derekmaeshiro/lebron/images/LEBRON_SOFTWARE_ARCHITECTURE.png

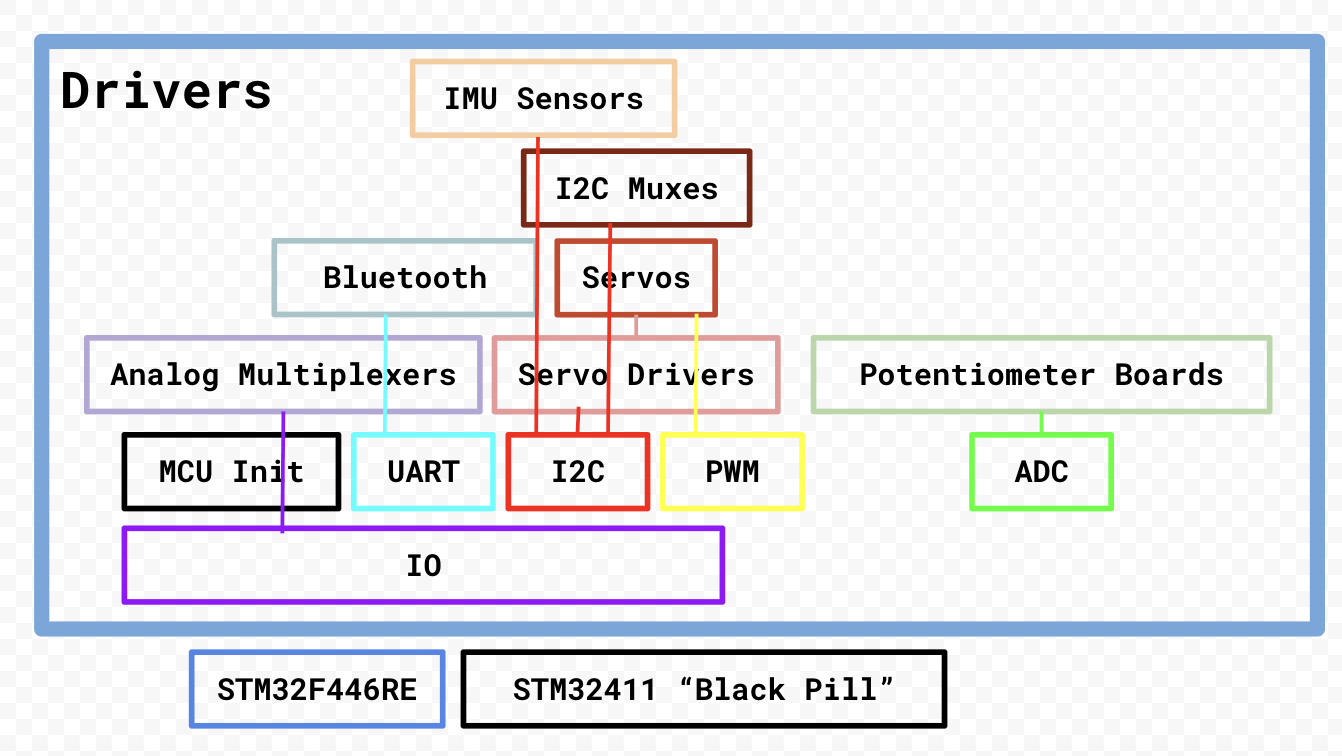
images/LEBRON_SOFTWARE_ARCHITECTURE.png
