derekmaeshiro/lebron/(commit log)

2025-07-11 build(makefile): specify the tools path for open-ocd and arm toolchain
    Make Makefile less hard-coded to a particular host by letting the path
    be specified by an environment variable.
    TOOLS_OPEN_OCD_DIR_PATH = /opt/homebrew/Cellar/open-ocd/0.12.0_1/share/openocd/scripts
    TOOLS_ARM_DIR_PATH = /Applications/ArmGNUToolchain/14.3.rel1/arm-none-eabi
2025-07-11 update tools path for arm-none-eabi-gcc in workflows
2025-07-12 removed include path and kept arm-gcc-include path for Makefile
2025-07-13 edit Makefile to include correct paths for led.c
    [defines.h, io.c, io.h, main.c]
2025-07-17 feat(drivers): implement IO handling
    The pinmapping for the nucleo works through LED test functions.
    I haven't set up the pinmapping for the Black Pill yet, but will do
    so at a later stage. Created enums to represent the pins (PA0 to PD2).
    IO Implementation uses resistor, output, input, MODER, and AFR registers
    to configure pins.
2025-07-18 1. add pin configurations using stm32 datasheet 2. configure each pin to either a) intentional pin that I will use or b) unused pin that may be used later on, which is set to analog 3. io_implementat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
2025-07-18 feat(build): pass hardware target as argument to make
    I hard code define to select between hardware targets (STM32F446RE and
    STM32F411) since each has different pinouts for programming. This
    handling is done in the Makefile using defines at compile time.
    Build for robotic arm: make HW=ROBOTIC_ARM
    Build for arm sleeve: make HW=ARM_SLEEVE
2025-07-19 add files that didn't get added the first time
    [io.c, main.c]
2025-07-21 feat(assert): add assert feature - doesn't use the BREAKPOINT feature by default since in STM32, under debugger mode, it stops the blinking completely. The blinking is important in visually recognizi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
    [assert_handler.c, assert_handler.h, defines.h, io.c, io.h, led.c, led.h, main.c]
2025-07-22 completed adc.h and temporarily set up IO_ANALOG_MUX_COM_1 pin for adc. also began basic configuration in adc_init for the ADC related registers
2025-07-22 feat(interrupts): add interrupts to io.c and test functions in test.c
    STM32 uses a similar process to other mcu's in the interrupt process.
    Instead of using ports to specify pins, it uses the pins directly. This
    means that there are only 16 possible pins that can be configured as an
    interrupt with 7 handlers in total. The process of configuring an
    interrupt starts by enabling the clock. Then, a pin is sslected and
    saved in teh SYSCFG register. Afterwards, the interrupt is disabled and
    a trigger is saved. Then, the interrupt is enabled.
    Interrupts must be globally enabled and are done so in the mcu_init
    function.
    The process of using them as a user in the test.c function is simple:
    1. io_co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
2025-07-23 minor syntax and type fixes to compile
    [adc.c, io.c, test.c]
2025-07-23 commented trace_init() in test.c to avoid error since UART implemented is not merged
    [test.c]
2025-07-23 added adc.c to makefile sources
2025-07-26 feat (printing): interrupts and polling function for printing characters to a string. also includes a ring buffer implementation that cycles through characters that get sent via UART.
2025-07-26 Add mpaland/printf as a submodule
2025-07-27 feat(trace): use external printf implementation for trace
    Use a more stripped-down external implementation and include it in the
    git submodule. Tracks the directory that the print statement ran and
    uses _putchar in uart.h.
2025-07-27 Update printf msubmodule ref
2025-07-27 Point printf submodule to my fork
2025-07-27 implemented pwm driver through timer peripheral. main functions include pwm_init() and pwm_set_duty_cycle() to vary pulse of the channel outputs
2025-07-27 feat(printf): include ability to see where printing takes place also, using addr2line, can get the assert value
2025-07-28 added servo.h and servo.c to provide an interface to set the pwm_duty_cycle based on the desired angle
2025-07-28 changed test.c to only test pwm when HW is defined as ROBOTIC_ARM
2025-07-30 feat(i2c) and feat(pwm_testing)
2025-07-31 feat(servo driver):
    made simple servo driver library that lets you set up servos to specific
    angles at specific channels.
    currently only works for channels 0 - 15 for one servo driver
2025-08-03 fixed bug that miscalculated value to write to ccr register. also simplified implementation in pwm.c to have the pwm channels always enabled to avoid extra and have the duty cycle be capable of going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
    [defines.h, io.c, pwm.c, test.c]
2025-08-04 configured adc for single conversion mode, simplifying approach to not need DMA or interrupts
2025-08-06 fix(i2c + uart) for the stm32f411
    [defines.h, main.c, mcu_init.c, test.c]
2025-08-07 added potentiomter implementation and began outline for mux implementation. the potentiometer layer is meant to read from either adc pin, while the mux will later be implemented to toggle between dif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
    [adc.c, adc.h, io.c, potentiometer.c, potentiometer.h, test.c]
2025-08-07 reworked logic between mux and potentiometer to be more clear. the potentiometer file will have a config mapping it to a mux board and a mux pin, and it will use a function from mux.h that will simul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
    [potentiometer.c, potentiometer.h]
2025-08-12 integrated analog_mux and potentiometer implementation to toggle mux then subsequently read adc value. also reworked adc to read a single channel rather than scan, to decrease number of inconsistent 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
    [adc.c, adc.h, analog_mux.c, analog_mux.h, io.c, potentiometer.c, potentiometer.h, test.c]
2025-08-13 configured second mux board with 4 additional GPIOA config pins
2025-08-18 added interface for sending potentiometer readings across bluetooth in uart.c. includes two functions, one to send potentiometer readings and one to deserialize/parse when receiving
2025-08-22 added test function to transfer potentiometer reading to channel 0 servo
2025-09-01 feat(imu_driver): reads imu sensors to calculate angles between joints. edit the i2c library to include drain configs for sda/scl
2025-09-03 feat(rx): added rx to uart library
2025-09-07 feat(imu_driver): add more features to increase precision of angles
2025-09-08 edit(pwm_driver): fixed configs and added new ones based on the 5 DC motors that will be used
    [io.c, io.h, pwm.c, pwm.h, test.c]
2025-09-08 edit frequency of pwm init
2025-09-08 fixing HW type errors
    [pwm.c]
2025-09-11 read_potentiometer edits with joints.h
2025-09-11 final commit before i send over my code to work on while my laptop gets fixed
    [test.c]
2025-09-11 dc motor pid loop logic working
2025-09-11 fixing motor driver joint structs
    [dc_motor_driver.c]
2025-09-11 edit joint struct
2025-09-11 motor joints struct change
2025-09-11 edit test case
2025-09-13 workflow works for only 1 cycle potentiometer to servo over bluetooth
2025-12-16 added servo_configs array to link joints to channel numbers. also included new function to test movement of the index finger
